dsigma/esp-led/art/wifi to led.png

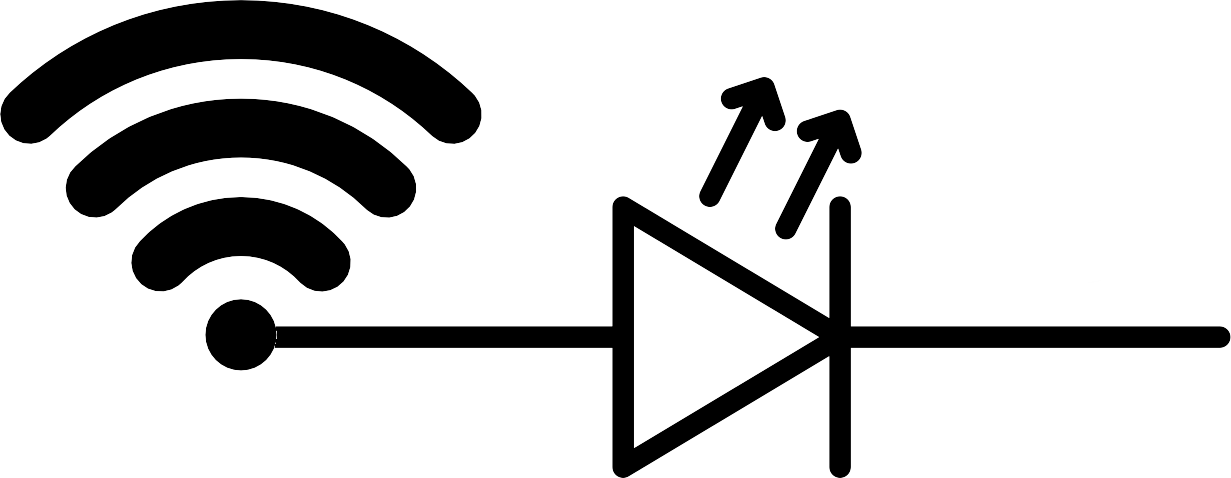
art/wifi to led.png
