dsigma/esp-led/footprints-and-symbols/3d-models/Texas_Instruments_-_TPS22810DBVR.step

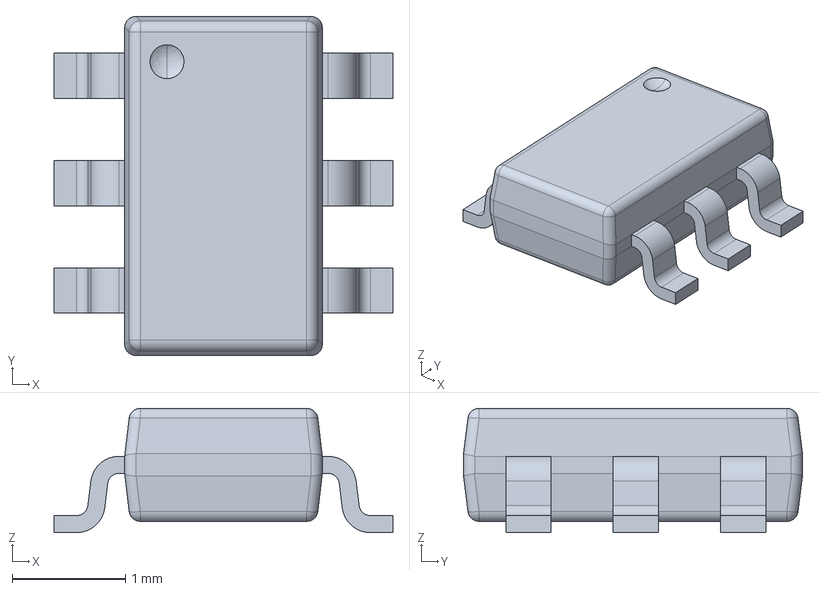
[picture p2: CAD file, 2020-12-28]
footprints-and-symbols/3d-models/Texas_Instruments_-_TPS22810DBVR.step
3.00 x 3.00 x 1.10 mm
