dsigma/esp-led/footprints-and-symbols/footprints/TXB0108PWR--3DModel-STEP-56544.STEP

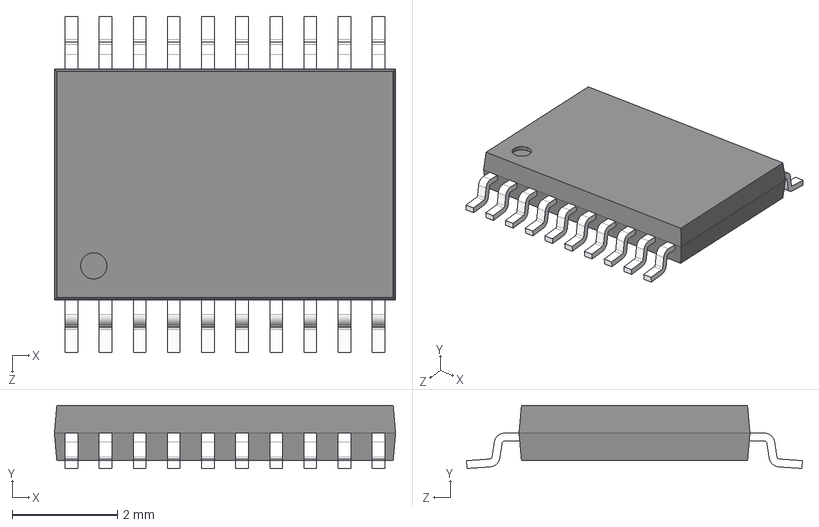
[picture p3: CAD file, 2020-03-29]
footprints-and-symbols/footprints/TXB0108PWR--3DModel-STEP-56544.STEP
6.50 x 1.20 x 6.40 mm
