dsigma/esp-led/v1.3/signal-board/build_products/signal-board.pdf

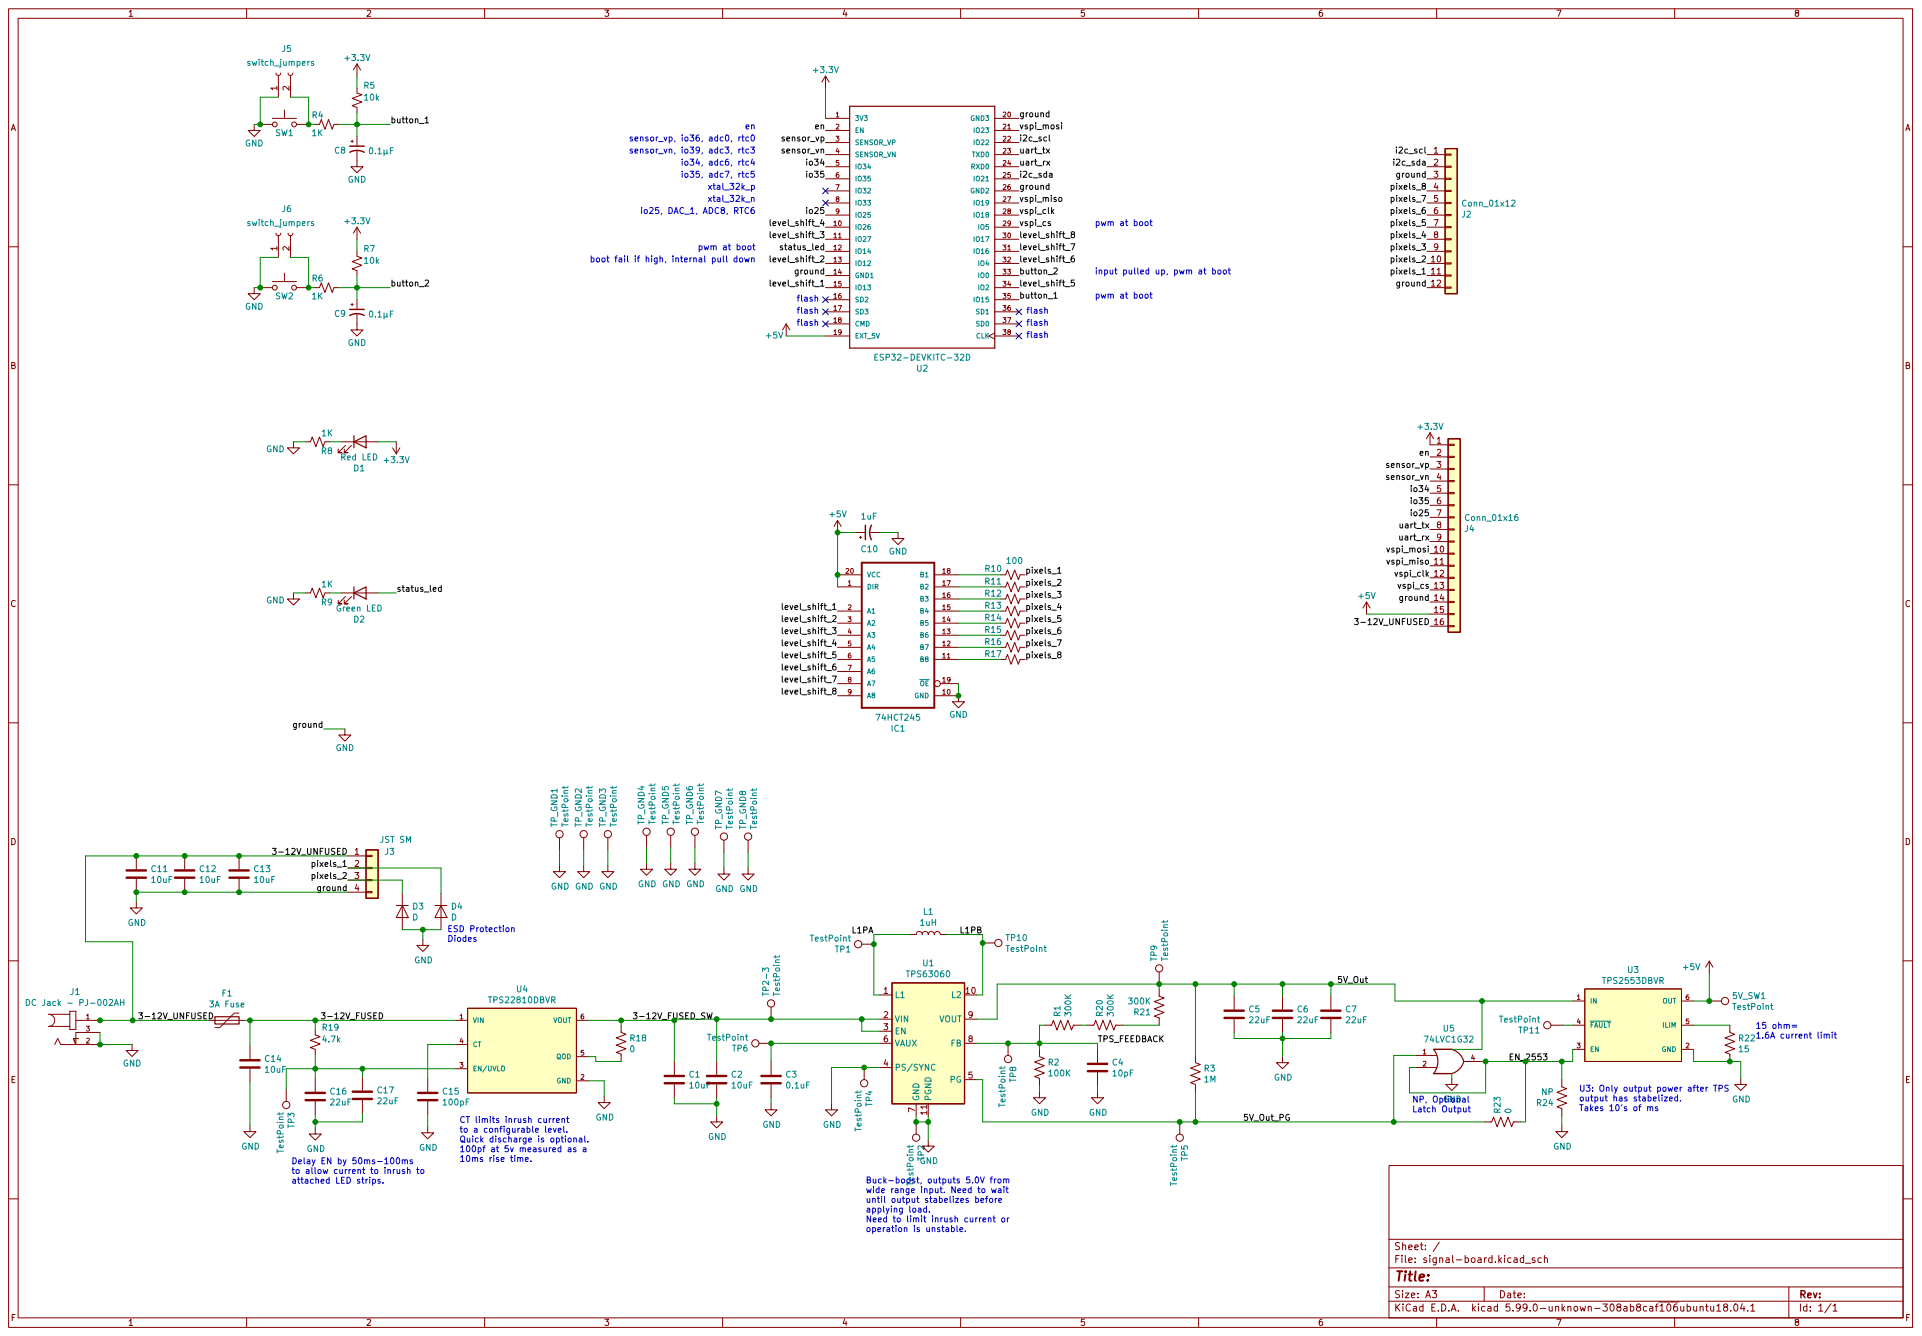
[picture p4: page 1]

boot fail if high, internal pull down

input pulled up, pwm at boot

7 FB 8 VOUT 9 U1 TPS63060 TP8 TestPoint GND TP_GND8 TestPoint GND GND GND TP_GND4 TestPoint TP_GND6 TestPoint TP_GND7 TestPoint TP_GND5 TestPoint VIN 1 CT 4 EN/UVLO 3 QOD 5 VOUT 6 GND 2 U4 TPS22810DBVR GND

File: signal-board.kicad_sch Sheet: / C3

U3: Only output power after TPS
output has stabelized. Takes 10's of ms

CT limits inrush current
to a configurable level.
Quick discharge is optional.
100pf at 5v measured as a 10ms rise time.

Delay EN by 50ms-100ms
to allow current to inrush to
attached LED strips.

Buck-boost, outputs 5.0V from
wide range input. Need to wait
until output stabelizes before
