dsigma/esp-led/v1.2/signal-board/build_products/gerbers/v1.1_schematic.pdf

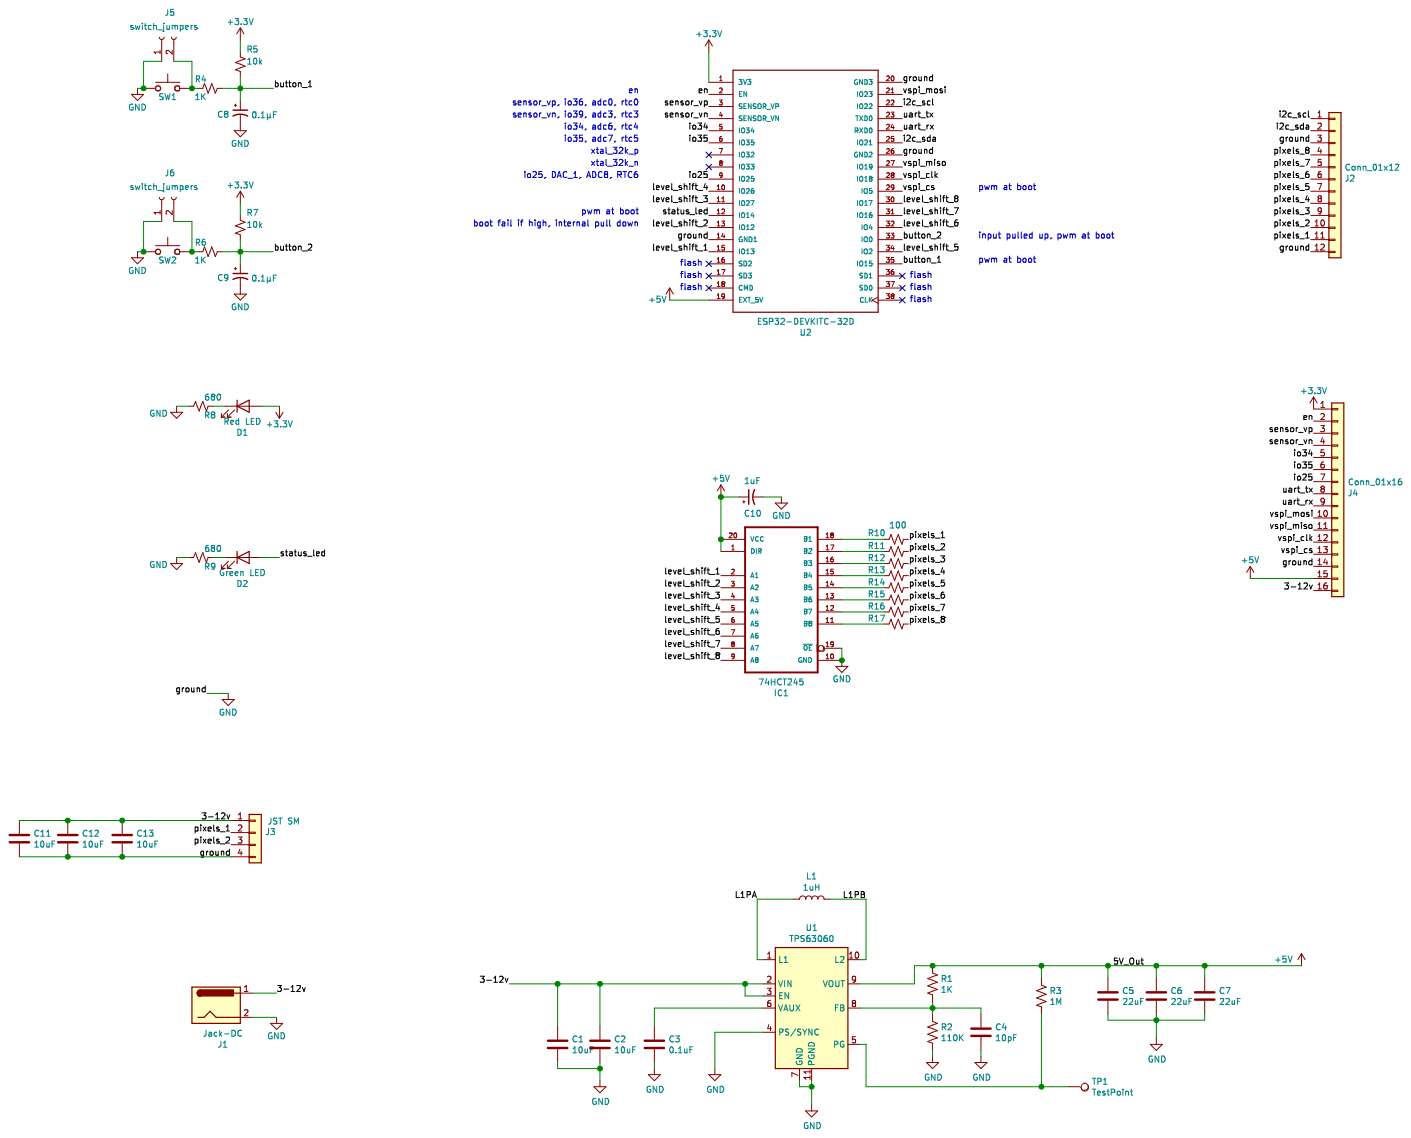
[picture p5: page 1]
