dsigma/esp-led/v1.3/signal-board/signal-board.kicad_pcb

## KiCad design v1.3/signal-board/signal-board.kicad_pcb (2021-03-12)

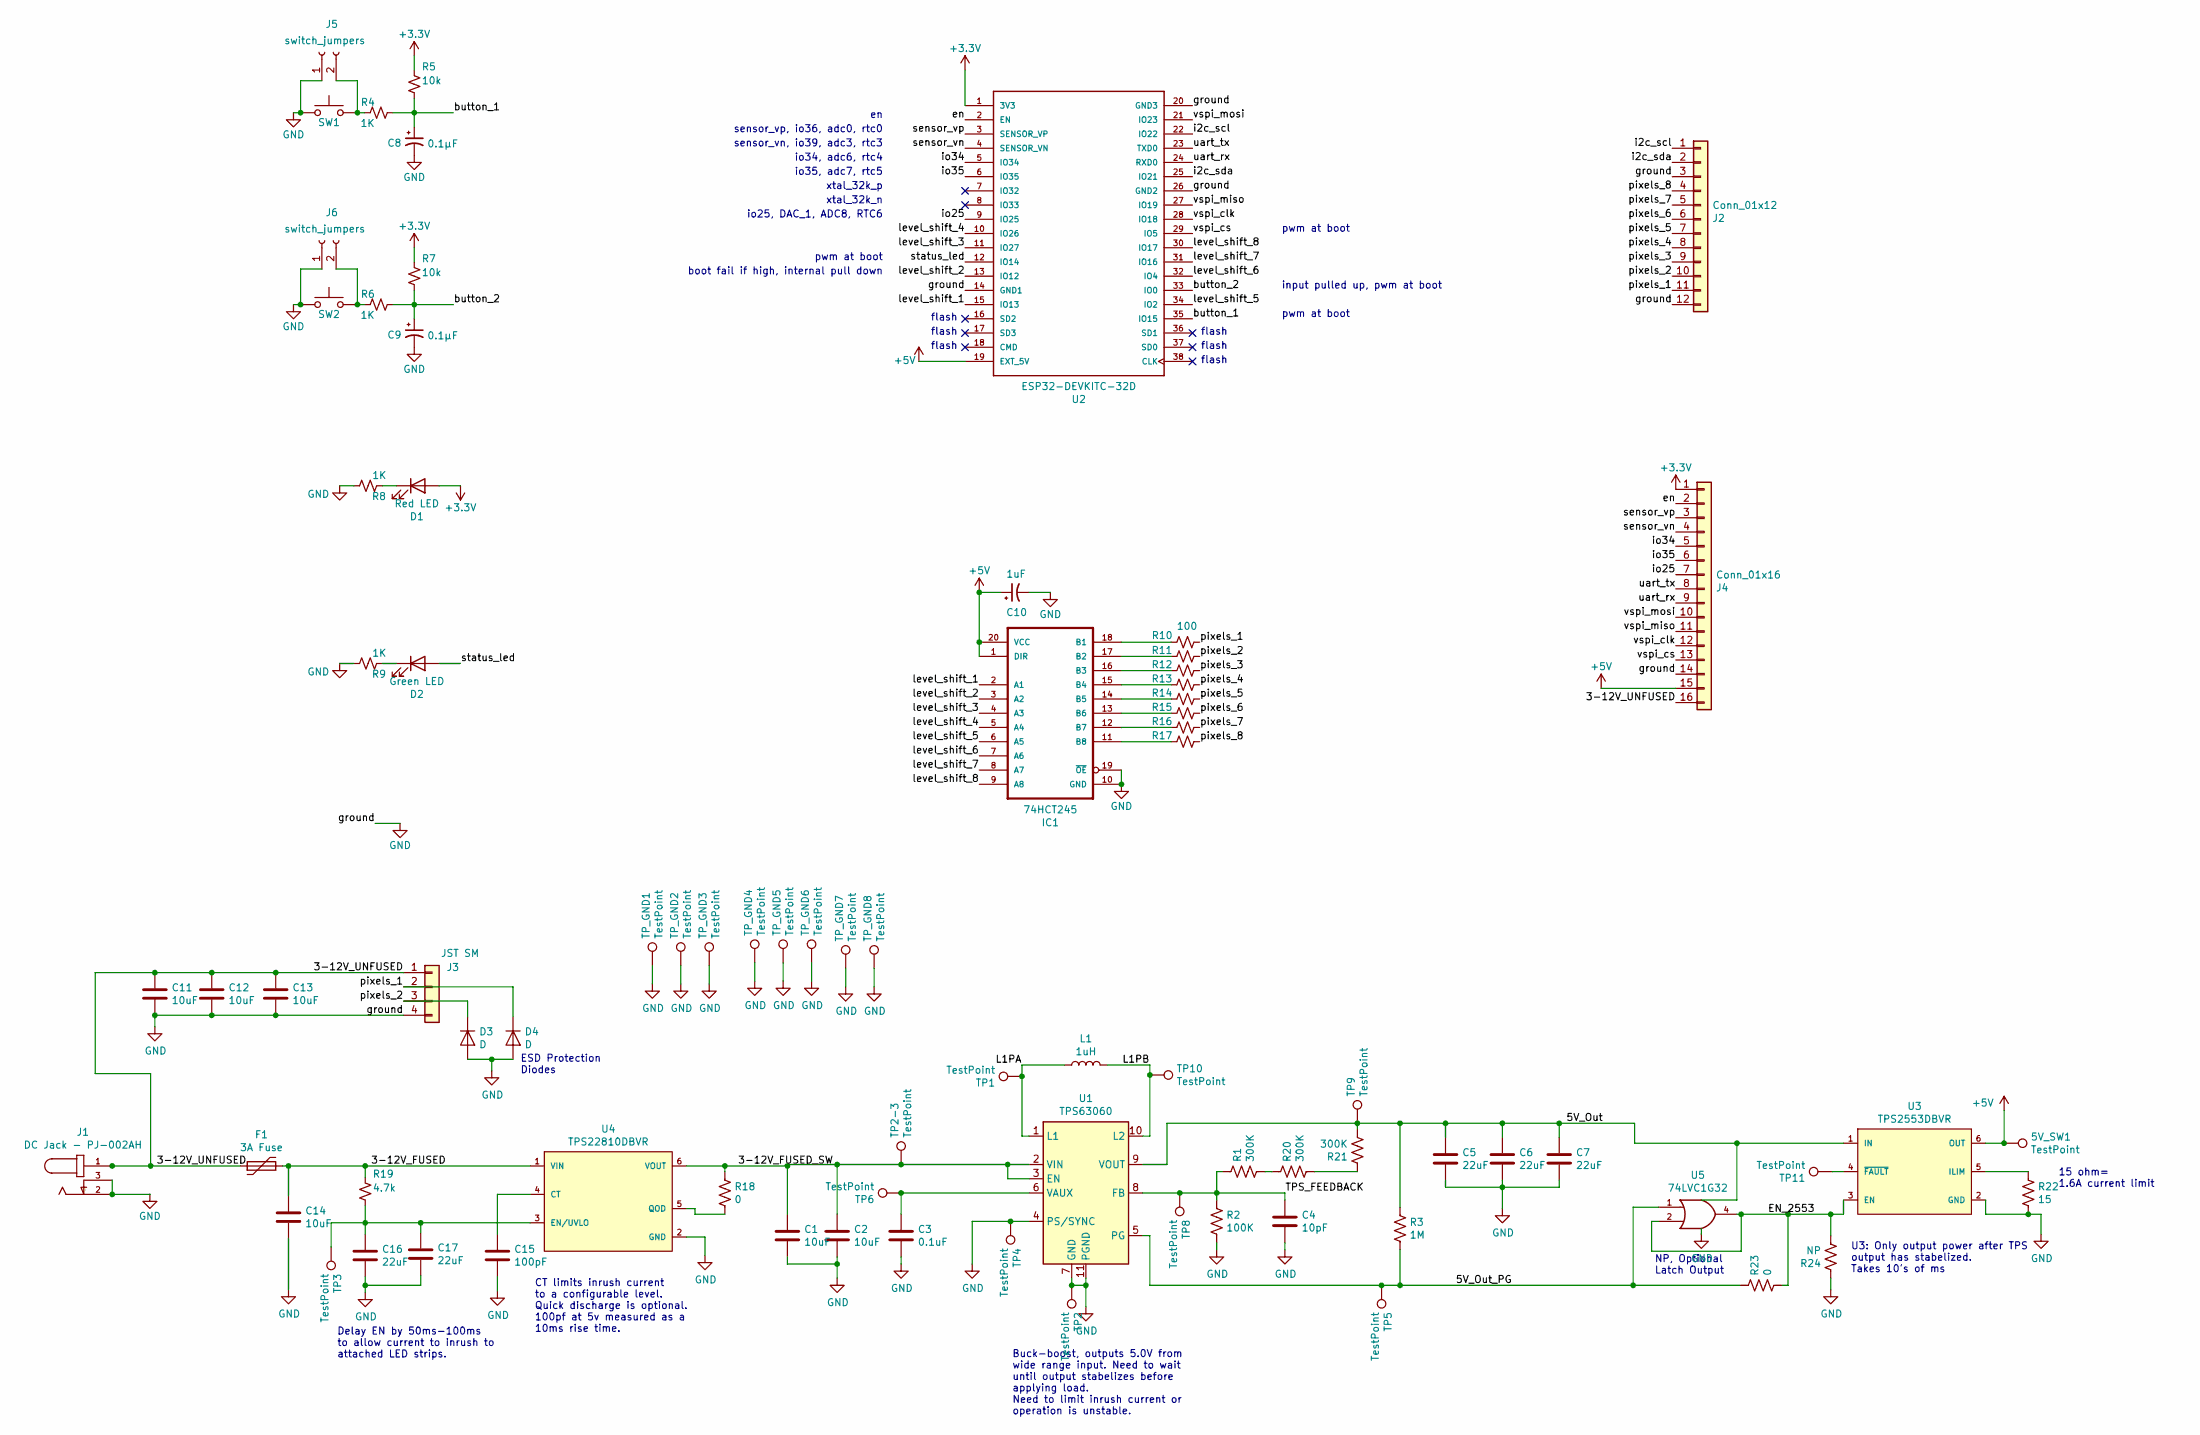
[picture p6: schematic signal-board.kicad_sch]

Parts:
5V_SW1: TestPoint; TestPoint_Pad_D1.0mm
C1, C2, C11, C12, C13, C14: 10uF; C_0805_2012Metric_Pad1.15x1.40mm_HandSolder; MouserPN 80-C0805C106K4PAC; DigiKeyPN 1276-6455-1-ND
C3: 0.1uF; C_0402_1005Metric; LCSC C1525
C4: 10pF; C_0402_1005Metric; LCSC C32949
C5, C6, C7: 22uF; C_0805_2012Metric_Pad1.15x1.40mm_HandSolder; MouserPN 81-GRM21BR61C226ME4L; DigiKeyPN 1276-6780-1-ND
C8, C9: 0.1µF; C_0402_1005Metric; LCSC C1525
C10: 1uF; C_0805_2012Metric_Pad1.15x1.40mm_HandSolder; LCSC C282736
C15: 100pF; C_0805_2012Metric_Pad1.15x1.40mm_HandSolder; LCSC C1790
C16, C17: 22uF; C_0805_2012Metric_Pad1.15x1.40mm_HandSolder; LCSC C45783
D1: Red LED; LED_0805_2012Metric; LCSC C84256
D2: Green LED; LED_0805_2012Metric; LCSC C2297
D3, D4: D; D_0603_1608Metric; LCSC C10677
F1: 3A Fuse; Fuse_1206_3216Metric; LCSC C182445
IC1: 74HCT245; SOIC-20W_7.5x10.0mm_P1.27mm; DigiKey100 0.336
J1: DC Jack - PJ-002AH; CUI_PJ-002AH
J2: Conn_01x12; PinHeader_1x12_P2.54mm_Vertical
J3: JST SM; jst-landing
J4: Conn_01x16; PinHeader_1x16_P2.54mm_Vertical
J5, J6: switch_jumpers; PinHeader_1x02_P2.54mm_Vertical
L1: 1uH; L_Taiyo-Yuden_NR-40xx_HandSoldering; MouserPN 963-NRS4018T1R0NDGJ; DigiKeyPN 587-2888-1-ND
R1, R20, R21: 300K; R_0402_1005Metric; LCSC C25774
R2: 100K; R_0402_1005Metric; LCSC C25741
R3: 1M; R_0402_1005Metric; LCSC C26083
R4, R6, R8, R9: 1K; R_0402_1005Metric; LCSC C11702
R5, R7: 10k; R_0402_1005Metric; LCSC C25744
R10, R11, R12, R13, R14, R15, R16, R17: 100; R_0805_2012Metric_Pad1.15x1.40mm_HandSolder; LCSC C17408
R18, R23: 0; R_0402_1005Metric; LCSC C17168
R19: 4.7k; R_0402_1005Metric; LCSC C25900
R22: 15; R_0402_1005Metric; LCSC C25083
R24: NP; R_0402_1005Metric
SW1, SW2: SW_MEC_5G; Tactile_Switch; LCSC C318886
TP1, TP2, TP2-3, TP3, TP4, TP5, TP6, TP8, TP9, TP10, TP11: TestPoint; TestPoint_Pad_D1.0mm
TP_GND1, TP_GND2, TP_GND3, TP_GND4, TP_GND5, TP_GND6, TP_GND7, TP_GND8: TestPoint; TestPoint_Pad_D1.0mm
U1: TPS63060; Texas_S-PWSON-N10_ThermalVias; MouserPN 595-TPS63060DSCR; DigiKey100 1.584
U2: ESP32-DEVKITC-32D; MODULE_ESP32-DEVKITC-32D
U3: TPS2553DBVR; SOT-23-6_Handsoldering; Rating Catalog; LCSC C55266
U4: TPS22810DBVR; SOT-23-6_Handsoldering; output voltage 18V; mouser part number 595-TPS22810DBVR; digikey description IC PWR SWITCH N-CHAN 1:1 6SOT23
U5: 74LVC1G32; SOT-353_SC-70-5_Handsoldering

Connections:
+3V3: D1.2 (A), J4.1, R5.1, R7.1, U2.1 (3V3)
+5V: 5V_SW1.1, C10.1, IC1.1 (DIR), IC1.20 (VCC), J4.15, U2.19 (EXT_5V), U3.6 (OUT)
/3-12V_FUSED: C14.1, F1.2, R19.1, U4.1 (VIN)
/3-12V_FUSED_SW: C1.1, C2.1, R18.1, TP2-3.1, U1.2 (VIN), U1.3 (EN), U4.6 (VOUT)
/3-12V_UNFUSED: C11.1, C12.1, C13.1, F1.1, J1.1, J3.1, J4.16
/5V_Out_PG: R3.2, R23.1, TP5.1, U1.5 (PG), U5.1
/EN_2553: R23.2, R24.2, U3.3 (EN), U5.2, U5.4
/L1PA: L1.1, TP1.1, U1.1 (L1)
/L1PB: L1.2, TP10.1, U1.10 (L2)
/TPS_FEEDBACK: C4.1, R1.1, R2.1, TP8.1, U1.8 (FB)
/button_1: C8.1, R4.2, R5.2, U2.35 (IO15)
/button_2: C9.1, R6.2, R7.2, U2.33 (IO0)
/en: J4.2, U2.2 (EN)
/i2c_scl: J2.1, U2.22 (IO22)
/i2c_sda: J2.2, U2.25 (IO21)
/io25: J4.7, U2.9 (IO25)
/io34: J4.5, U2.5 (IO34)
/io35: J4.6, U2.6 (IO35)
/level_shift_1: IC1.2 (A1), U2.15 (IO13)
/level_shift_2: IC1.3 (A2), U2.13 (IO12)
/level_shift_3: IC1.4 (A3), U2.11 (IO27)
/level_shift_4: IC1.5 (A4), U2.10 (IO26)
/level_shift_5: IC1.6 (A5), U2.34 (IO2)
/level_shift_6: IC1.7 (A6), U2.32 (IO4)
/level_shift_7: IC1.8 (A7), U2.31 (IO16)
/level_shift_8: IC1.9 (A8), U2.30 (IO17)
/pixels_1: D4.1 (K), J2.11, J3.2, R10.2
/pixels_2: D3.1 (K), J2.10, J3.3, R11.2
/pixels_3: J2.9, R12.2
/pixels_4: J2.8, R13.2
/pixels_5: J2.7, R14.2
/pixels_6: J2.6, R15.2
/pixels_7: J2.5, R16.2
/pixels_8: J2.4, R17.2
/sensor_vn: J4.4, U2.4 (SENSOR_VN)
/sensor_vp: J4.3, U2.3 (SENSOR_VP)
/status_led: D2.2 (A), U2.12 (IO14)
/uart_rx: J4.9, U2.24 (RXD0)
/uart_tx: J4.8, U2.23 (TXD0)
/vspi_clk: J4.12, U2.28 (IO18)
/vspi_cs: J4.13, U2.29 (IO5)
/vspi_miso: J4.11, U2.27 (IO19)
/vspi_mosi: J4.10, U2.21 (IO23)
GND: C1.2, C2.2, C3.2, C4.2, C5.2, C6.2, C7.2, C8.2, C9.2, C10.2, C11.2, C12.2, C13.2, C14.2, C15.2, C16.2, C17.2, D3.2 (A), D4.2 (A), IC1.10 (GND), IC1.19 (~OE~), J1.2, J1.3, J2.3, J2.12, J3.4, J4.14, J5.1, J6.1, R2.2, R8.2, R9.2, R22.2, R24.1, SW1.1 (A), SW1.2 (A), SW2.1 (A), SW2.2 (A), TP2.1, TP4.1, TP_GND1.1, TP_GND2.1, TP_GND3.1, TP_GND4.1, TP_GND5.1, TP_GND6.1, TP_GND7.1, TP_GND8.1, U1.4 (PS/SYNC), U1.7 (GND), U1.11 (PGND), U2.14 (GND1), U2.20 (GND3), U2.26 (GND2), U3.2 (GND), U4.2 (GND), U5.3 (GND)
unnamed: C3.1, TP6.1, U1.6 (VAUX)
unnamed: C15.1, U4.4 (CT)
unnamed: C16.1, C17.1, R19.2, TP3.1, U4.3 (EN/UVLO)
unnamed: D1.1 (K), R8.1
unnamed: D2.1 (K), R9.1
unnamed: IC1.11 (B8), R17.1
unnamed: IC1.12 (B7), R16.1
unnamed: IC1.13 (B6), R15.1
unnamed: IC1.14 (B5), R14.1
unnamed: IC1.15 (B4), R13.1
unnamed: IC1.16 (B3), R12.1
unnamed: IC1.17 (B2), R11.1
unnamed: IC1.18 (B1), R10.1
unnamed: J5.2, R4.1, SW1.3 (B), SW1.4 (B)
unnamed: J6.2, R6.1, SW2.3 (B), SW2.4 (B)
unnamed: R1.2, R20.1
unnamed: R18.2, U4.5 (QOD)
unnamed: R20.2, R21.1
unnamed: R22.1, U3.5 (ILIM)
unnamed: TP11.1, U3.4 (~FAULT~)
VCC: C5.1, C6.1, C7.1, R3.1, R21.2, TP9.1, U1.9 (VOUT), U3.1 (IN), U5.5 (VCC)

Notes on the sheet:
Delay EN by 50ms-100ms to allow current to inrush to attached LED strips.
ESD Protection Diodes
CT limits inrush current to a configurable level. Quick discharge is optional. 100pf at 5v measured as a 10ms rise time.
sensor_vp, io36, adc0, rtc0
sensor_vn, io39, adc3, rtc3
io34, adc6, rtc4
io35, adc7, rtc5
xtal_32k_p
xtal_32k_n
io25, DAC_1, ADC8, RTC6
pwm at boot
boot fail if high, internal pull down
flash
Buck-boost, outputs 5.0V from wide range input. Need to wait until output stabelizes before applying load. Need to limit inrush current or operation is unstable.
input pulled up, pwm at boot
NP, Optional Latch Output
U3: Only output power after TPS output has stabelized. Takes 10's of ms
15 ohm= 1.6A current limit

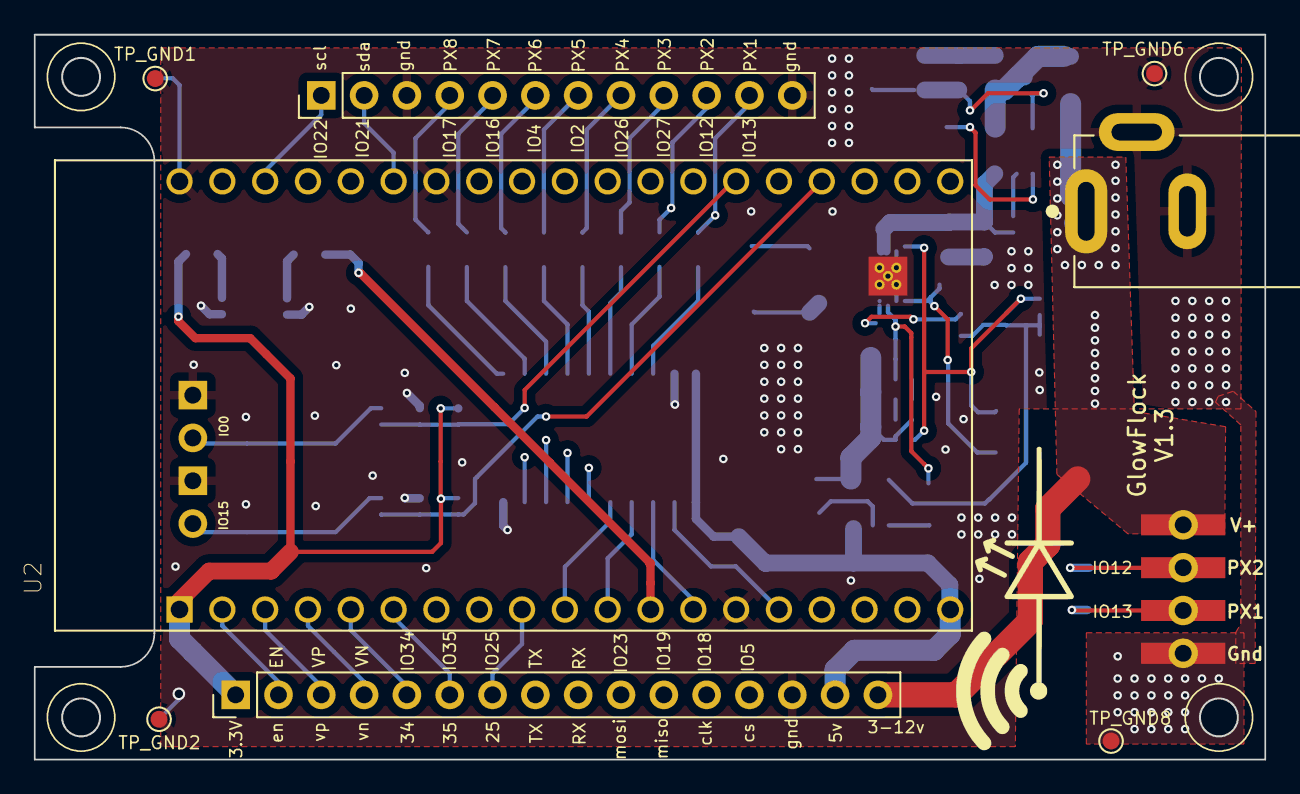
[picture p7: board v1.3/signal-board/signal-board.kicad_pcb from above]

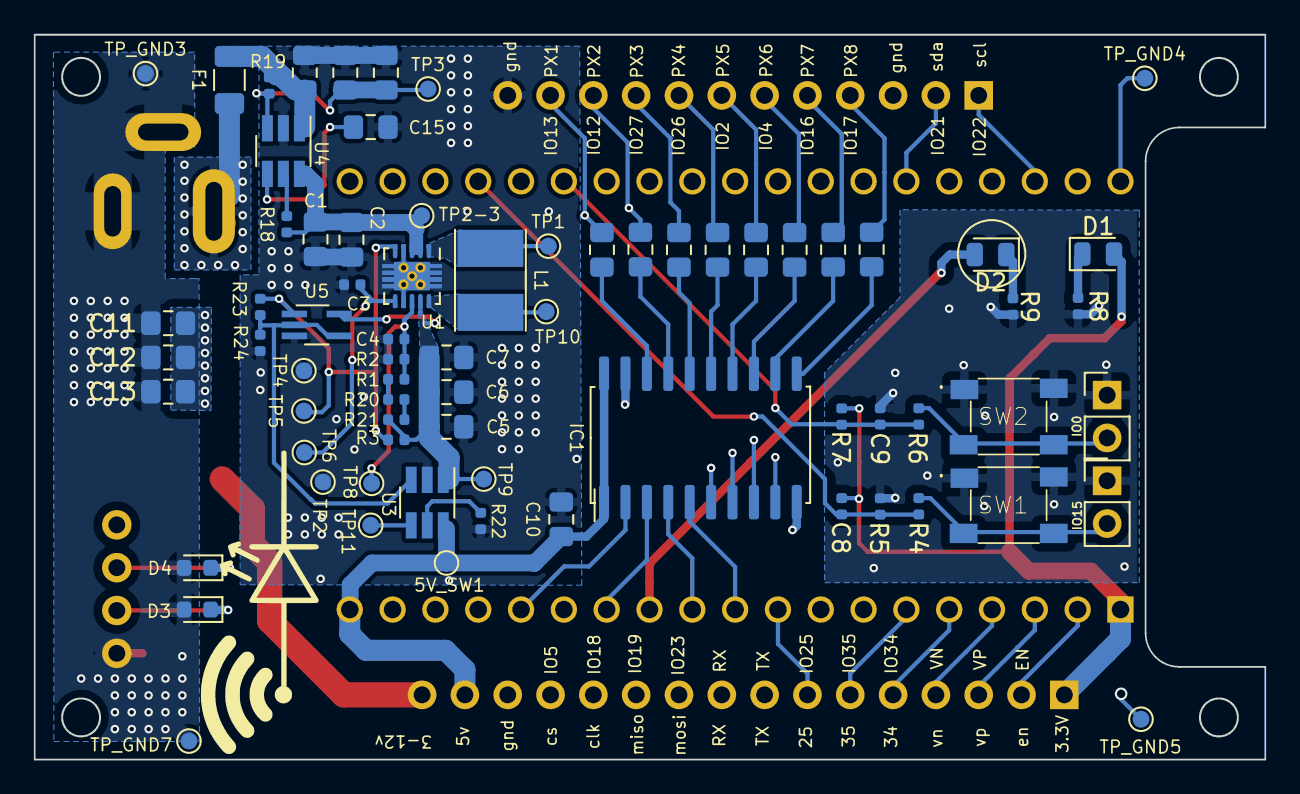
[picture p8: board v1.3/signal-board/signal-board.kicad_pcb from below]

Board: 4 copper layers, 73.0 x 43.0 mm, 81 parts (72 on the bottom side), 65 nets.
