dsigma/esp-led/v1.2/buck-boost-sps/buck-boost-sps.kicad_pcb

## KiCad design v1.2/buck-boost-sps/buck-boost-sps.kicad_pcb (2020-08-18, an earlier design)

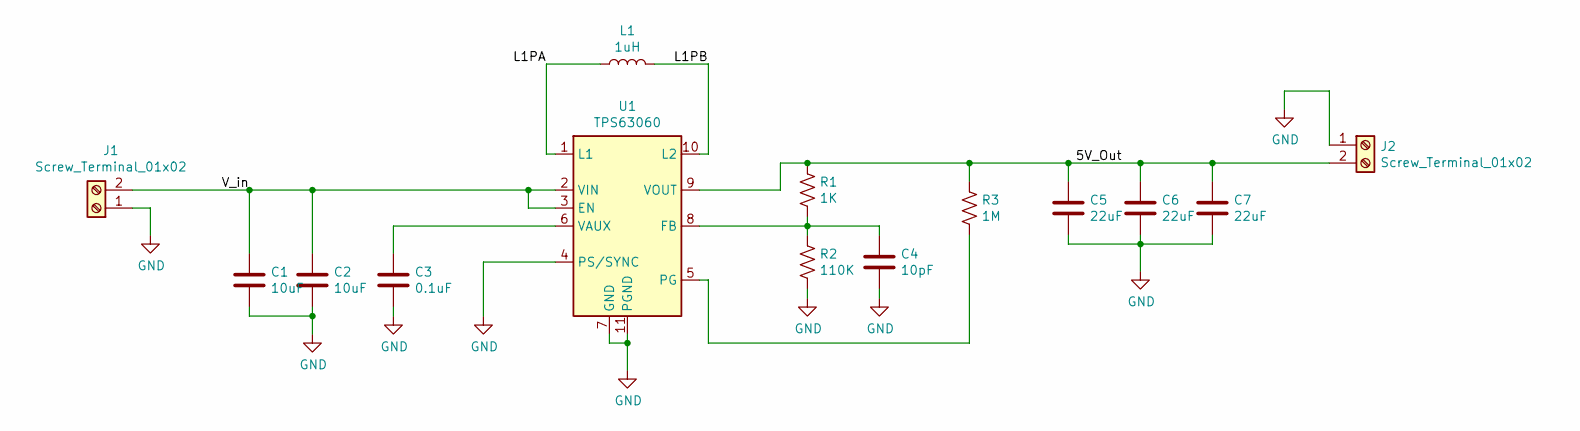
[picture p9: schematic buck-boost-sps.sch]

Parts:
C1, C2: 10uF; C_0805_2012Metric_Pad1.15x1.40mm_HandSolder; MouserPN 80-C0805C106K4PAC; DigiKeyPN 1276-6455-1-ND
C3: 0.1uF; C_0805_2012Metric_Pad1.15x1.40mm_HandSolder; MouserPN 80-C0805C104K5RACLR; Mouser100 0.037
C4: 10pF; C_0805_2012Metric_Pad1.15x1.40mm_HandSolder; MouserPN 80-C0805C100J3HACTU; DigiKeyPN 1276-2563-1-ND
C5, C6, C7: 22uF; C_0805_2012Metric_Pad1.15x1.40mm_HandSolder; MouserPN 81-GRM21BR61C226ME4L; DigiKeyPN 1276-6780-1-ND
J1, J2: Screw_Terminal_01x02; TerminalBlock_TE_282834-2_1x02_P2.54mm_Horizontal; MouserPN 571-282834-2; DigiKeyPN A98333-ND
L1: 1uH; L_Taiyo-Yuden_NR-40xx_HandSoldering; MouserPN 963-NRS4018T1R0NDGJ; DigiKeyPN 587-2888-1-ND
R1: 1K; R_0805_2012Metric_Pad1.15x1.40mm_HandSolder; MouserPN 71-CRCW08051K00FKEAC; DigiKeyPN P123793CT-ND
R2: 110K; R_0805_2012Metric_Pad1.15x1.40mm_HandSolder; MouserPN 603-RT0805FRE07110RL; DigiKeyPN 311-110KCRCT-ND
R3: 1M; R_0805_2012Metric_Pad1.15x1.40mm_HandSolder; MouserPN 71-CRCW08051M00FKEAC; DigiKeyPN 311-1.00MCRCT-ND
U1: TPS63060; Texas_S-PWSON-N10_ThermalVias; MouserPN 595-TPS63060DSCR; DigiKey100 1.584

Connections:
/5V_Out: C5.1, C6.1, C7.1, J2.2, R1.1, R3.1, U1.9 (VOUT)
/L1PA: L1.1, U1.1 (L1)
/L1PB: L1.2, U1.10 (L2)
/V_in: C1.1, C2.1, J1.2, U1.2 (VIN), U1.3 (EN)
GND: C1.2, C2.2, C3.2, C4.2, C5.2, C6.2, C7.2, J1.1, J2.1, R2.2, U1.4 (PS/SYNC), U1.7 (GND), U1.11 (PGND)
unnamed: C3.1, U1.6 (VAUX)
unnamed: C4.1, R1.2, R2.1, U1.8 (FB)
unnamed: R3.2, U1.5 (PG)

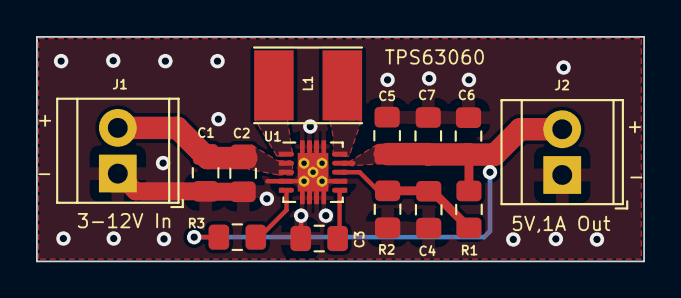
[picture p10: board buck-boost-sps.kicad_pcb from above]

Board: 2 copper layers, 33.7 x 12.5 mm, 14 parts (0 on the bottom side), 8 nets.
