dsigma/esp-led/v1.0/signal-board/signal-board.kicad_pcb

## KiCad design v1.0/signal-board/signal-board.kicad_pcb (2020-08-18, an earlier design)

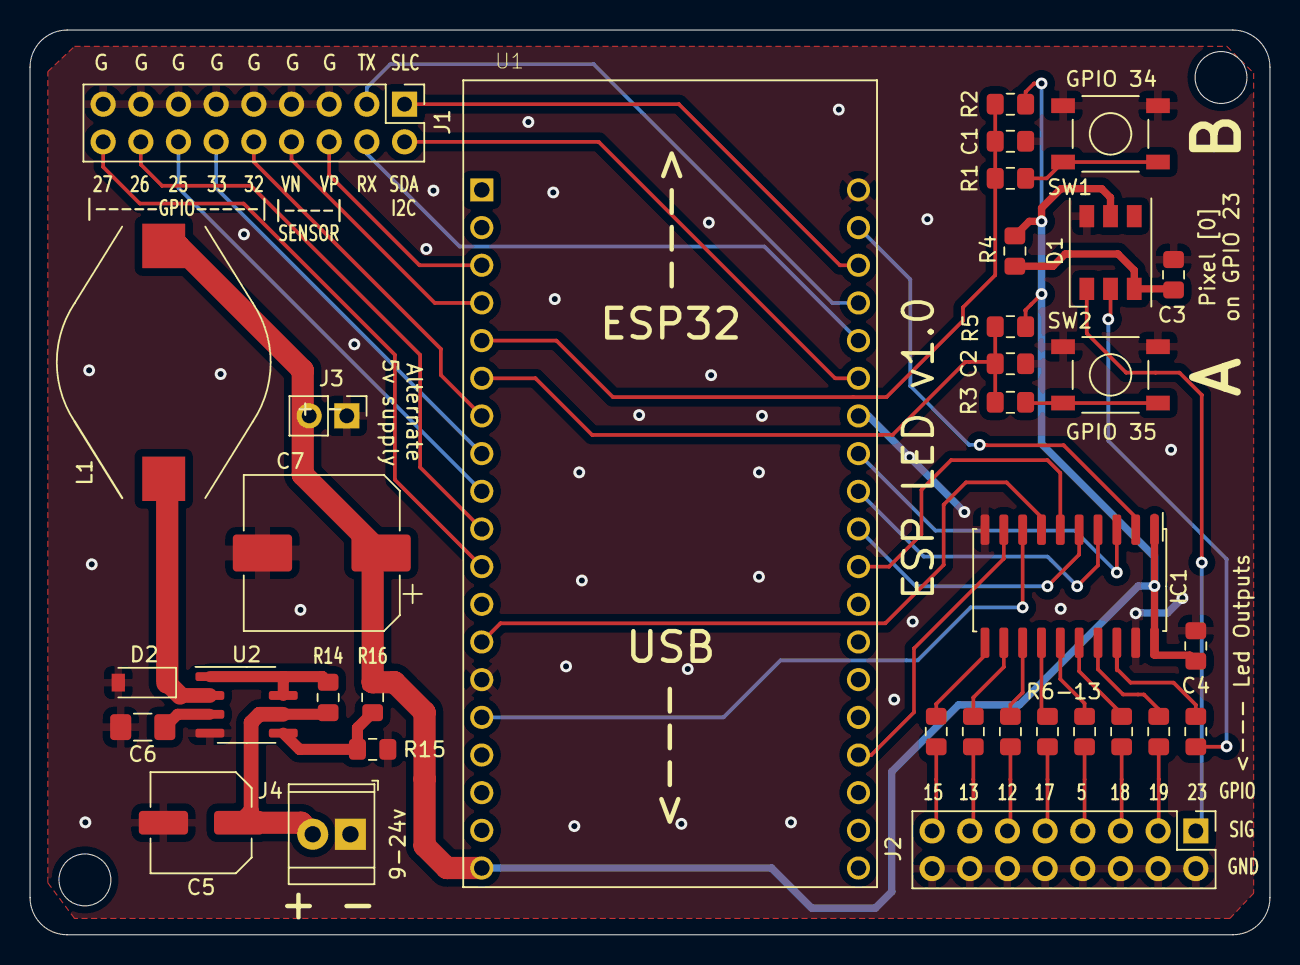
[picture p11: board v1.0/signal-board/signal-board.kicad_pcb from above]

Board: 2 copper layers, 83.6 x 61.0 mm, 35 parts (0 on the bottom side), 48 nets.

Parts:
C1, C2, C3: 0.1µF; C_0805_2012Metric_Pad1.15x1.40mm_HandSolder
C4: 1uF; C_0805_2012Metric_Pad1.15x1.40mm_HandSolder
C5: 100uF; C_Elec_6.3x7.7
C6: 470pF; C_1206_3216Metric_Pad1.42x1.75mm_HandSolder
C7: 220uF; CP_Elec_10x10
D1: WS2812; LED_WS2812_PLCC6_5.0x5.0mm_P1.6mm
D2: 1N5819; D_SOD-123
IC1: 74HCT245; SOIC-20W_7.5x10.0mm_P1.27mm
J1: Conn_02x09_Odd_Even; PinHeader_2x09_P2.54mm_Vertical
J2: Conn_02x08_Odd_Even; PinHeader_2x08_P2.54mm_Vertical
J3: 5V Pwr Conn; PinHeader_1x02_P2.54mm_Vertical
J4: 24V Screw Term; TerminalBlock_TE_282834-2_1x02_P2.54mm_Horizontal
L1: 220uH; L_Bourns_SDR1806
R1, R3: 1k; R_0805_2012Metric_Pad1.15x1.40mm_HandSolder
R2, R5: 10k; R_0805_2012Metric_Pad1.15x1.40mm_HandSolder
R4: 150; R_0805_2012Metric_Pad1.15x1.40mm_HandSolder
R6, R7, R8, R9, R10, R11, R12, R13: 100; R_0805_2012Metric_Pad1.15x1.40mm_HandSolder
R14: 0.33 ohms; R_0805_2012Metric_Pad1.15x1.40mm_HandSolder
R15: 1.2K; R_0805_2012Metric_Pad1.15x1.40mm_HandSolder
R16: 3.6K; R_0805_2012Metric_Pad1.15x1.40mm_HandSolder
SW1, SW2: SW_MEC_5G; SW_PTS525SM15SMTR2LFS
U1: ESP32-DEVKITC-32D; MODULE_ESP32-DEVKITC-32D
U2: MC33063AD; SOIC-8_3.9x4.9mm_P1.27mm

Connections:
7V_to_24V_Input: C5.1, J4.2, R14.1, U2.6
+5V: C4.1, C7.1, D1.5, IC1.1, IC1.20, J3.2, L1.2, R2.1, R4.1, R5.1, R16.2, U1.19
GND: C1.2, C2.2, C3.2, C4.2, C5.2, C6.2, C7.2, D1.6, D2.2, IC1.10, IC1.19, J1.5, J1.7, J1.9, J1.11, J1.13, J1.15, J1.17, J2.2, J2.4, J2.6, J2.8, J2.10, J2.12, J2.14, J2.16, J3.1, J4.1, R15.2, SW1.1, SW1.2, SW2.1, SW2.2, U1.14, U1.20, U1.26, U2.4
unnamed: C1.1, R1.2, R2.2, U1.5
unnamed: C2.1, R3.2, R5.2, U1.6
unnamed: C3.1, D1.3, R4.2
unnamed: C6.1, U2.3
unnamed: D1.1, J2.1
unnamed: D1.2, R6.2
unnamed: D2.1, L1.1, U2.2
unnamed: IC1.2, U1.21
unnamed: IC1.3, U1.27
unnamed: IC1.4, U1.28
unnamed: IC1.5, U1.29
unnamed: IC1.6, U1.30
unnamed: IC1.7, U1.13
unnamed: IC1.8, U1.15
unnamed: IC1.9, U1.35
unnamed: IC1.11, R13.1
unnamed: IC1.12, R12.1
unnamed: IC1.13, R11.1
unnamed: IC1.14, R10.1
unnamed: IC1.15, R9.1
unnamed: IC1.16, R8.1
unnamed: IC1.17, R7.1
unnamed: IC1.18, R6.1
unnamed: J1.1, U1.22
unnamed: J1.2, U1.25
unnamed: J1.3, U1.23
unnamed: J1.4, U1.24
unnamed: J1.6, U1.3
unnamed: J1.8, U1.4
unnamed: J1.10, U1.7
unnamed: J1.12, U1.8
unnamed: J1.14, U1.9
unnamed: J1.16, U1.10
unnamed: J1.18, U1.11
unnamed: J2.3, R7.2
unnamed: J2.5, R8.2
unnamed: J2.7, R9.2
unnamed: J2.9, R10.2
unnamed: J2.11, R11.2
unnamed: J2.13, R12.2
unnamed: J2.15, R13.2
unnamed: R1.1, SW1.3, SW1.4
unnamed: R3.1, SW2.3, SW2.4
unnamed: R14.2, U2.1, U2.7, U2.8
unnamed: R15.1, R16.1, U2.5
