dsigma/esp-led/old designs/power_supply/sps_power/sps_power.kicad_pcb

## KiCad design old designs/power_supply/sps_power/sps_power.kicad_pcb (2020-03-30, an earlier design)

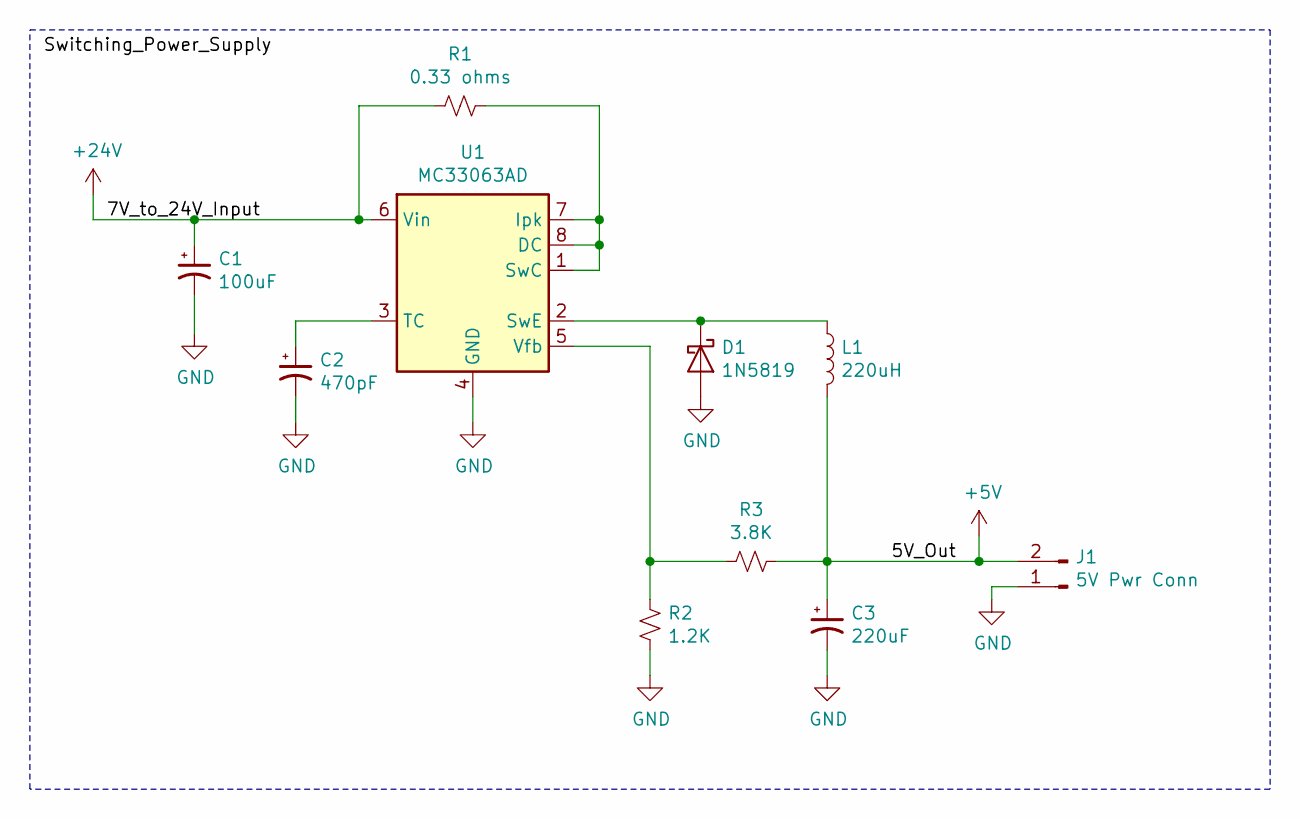
[picture p12: schematic sps_power.sch]

Parts:
C1: 100uF; CP_Radial_D5.0mm_P2.50mm
C2: 470pF; C_1206_3216Metric_Pad1.42x1.75mm_HandSolder
C3: 220uF; CP_Elec_10x10
D1: 1N5819; D_SOD-123
J1: 5V Pwr Conn; PinHeader_1x02_P1.00mm_Vertical
L1: 220uH; L_Bourns-SRR1005
R1: 0.33 ohms; R_0805_2012Metric_Pad1.15x1.40mm_HandSolder
R2: 1.2K; R_0805_2012Metric_Pad1.15x1.40mm_HandSolder
R3: 3.8K; R_0805_2012Metric_Pad1.15x1.40mm_HandSolder
U1: MC33063AD; SOIC-8_3.9x4.9mm_P1.27mm

Connections:
+24V: C1.1, R1.1, U1.6 (Vin)
GND: C1.2, C2.2, C3.2, D1.2 (A), J1.1, R2.2, U1.4 (GND)
unnamed: C2.1, U1.3 (TC)
unnamed 3: C3.1, J1.2, L1.2, R3.2; also elsewhere on the board
unnamed: D1.1 (K), L1.1, U1.2 (SwE)
unnamed: R1.2, U1.1 (SwC), U1.7 (Ipk), U1.8 (DC)
unnamed: R2.1, R3.1, U1.5 (Vfb)

Board: 2 copper layers, 11 parts (0 on the bottom side), 7 nets, no tracks yet.

Other parts of the board:
TP1: 5V_Out; TestPoint_Pad_D2.0mm

Their connections:
unnamed 3: TP1.1; also elsewhere on the board
