dsigma/esp-led/(commit log)

2020-03-28 datasheet and footprints
2020-03-29 basic signal flow schematic
    [TXB0108PWR--3DModel-STEP-56544.STEP, signal-board.kicad_pcb, signal-board.sch]
2020-03-29 Rough layout for power supply circuit
    [sps_power.kicad_pcb, sps_power.sch]
2020-03-29 Interum commit
    [sps_power.kicad_pcb, sps_power.sch]
2020-03-30 Interum power supply cad commit
    [sps_power.csv, sps_power.kicad_pcb, sps_power.sch]
2020-03-30 more signal board
    [signal-board.csv, signal-board.kicad_pcb]
2020-03-31 BOM made
    [signal-board.csv, signal-board.sch]
2020-03-31 some footprints
    [signal-board.sch]
2020-04-02 signal board stufffffff
    [signal-board.kicad_pcb]
2020-04-02 Copied power supply circuit into signal board schematic, initial creation of PCB
    [signal-board.kicad_pcb, signal-board.sch, sps_power.csv, sps_power.sch]
2020-04-03 More footprints and rough layout of pcb
    [signal-board.kicad_pcb, signal-board.sch]
2020-04-06 traces 1.0 done
    [signal-board.kicad_pcb, signal-board.sch]
2020-04-07 Updated packages footprints and added ground plane stitching
    [signal-board.kicad_pcb, signal-board.sch]
2020-04-07 A B, esp direction, holes
    [signal-board.kicad_pcb]
2020-04-10 Updated resistor part numbers on feedback circuit for power supply
    [signal-board.sch]
2020-04-16 art and design rules
    [signal-board.kicad_pcb]
2020-04-16 correcting warnings
    [signal-board.kicad_pcb]
2020-04-17 Fixed DRC check error with alternate 5V supply footprint using 2.54mm instead of 1.0mm 1x2 header
    [signal-board.kicad_pcb, signal-board.sch]
2020-05-02 Added blinky light sample code for the ESP-LED PCB
2020-08-18 v2 progress on schematic
    [buck-boost-sps.kicad_pcb, buck-boost-sps.sch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]
2020-08-18 schematic re-org
    [signal-board.sch]
2020-08-26 footprint updates
    [signal-board.kicad_pcb, signal-board.sch]
2020-08-27 JLC PCB changes
    [signal-board.kicad_pcb, signal-board.sch]
2020-09-19 updated v1.1 power layout
    [signal-board.kicad_pcb, signal-board.sch]
2020-09-20 updated notes and updates from board review
    [signal-board.csv, signal-board.kicad_pcb, signal-board.sch]
2020-10-13 circuit updates
    [signal-board.kicad_pcb, signal-board.kicad_sch]
2020-10-13 build files for JLCPCB
    [signal-board-B_Cu.gbr, signal-board-B_Mask.gbr, signal-board-B_Paste.gbr, signal-board-B_SilkS.gbr, signal-board-Edge_Cuts.gbr, signal-board-F_Cu.gbr, signal-board-F_Mask.gbr, signal-board-F_Paste.gbr]
2020-10-13 kicad BOM generator util for JLCPCB
2020-11-22 added v1.2 folder
    [buck-boost-sps.kicad_pcb, buck-boost-sps.sch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]
2020-11-22 added holes to corners
    [signal-board.kicad_pcb, signal-board.kicad_sch]
2020-11-22 reorganized footprints and symbols
    [TXB0108PWR--3DModel-STEP-56544.STEP]
2020-11-22 updated symbol and footprint links
    [signal-board.kicad_pcb, signal-board.kicad_sch]
2020-11-22 got rid of footprints, added new dc jack
    [signal-board.kicad_sch]
2020-11-23 cleanup, new plug
    [signal-board.kicad_pcb, signal-board.kicad_sch, signal-board.sch]
2020-12-28 updates for v1.2
    [Texas_Instruments_-_TPS22810DBVR.step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]
2021-03-12 1.3 board
    [signal-board-B_Cu.gbr, signal-board-B_Mask.gbr, signal-board-B_Paste.gbr, signal-board-B_Silkscreen.gbr, signal-board-Edge_Cuts.gbr, signal-board-F_Cu.gbr, signal-board-F_Mask.gbr, signal-board-F_Paste.gbr]
